jt0mkins/Pressure_Strips/pressure_strips/BOM_pressure_strips_reviewed.csv

Reference | Qty | Value | Description | Package | Manufacturer | MPN | LCSC | Voltage / Rating | Tolerance / Spec | Datasheet | Notes
U1,U2,U3,U4,U5,U6,U8,U9 | 8 | ILPS28QSW | Absolute digital barometric pressure sensor, dual FS (1260/4060 hPa), I2C / MIPI I3C, Qvar | HCLGA-7L 2.8x2.8x1.95mm | STMicroelectronics | ILPS28QSW (reel: ILPS28QSWTR) | C5267414 | 1.7-3.6 V (abs max ~4.8 V) | Pressure abs. accuracy +/-0.5 hPa | https://www.st.com/resource/en/datasheet/ilps28qsw.pdf | Fixed I2C address 0x5C (no SA0 pin) - reason the mux is needed. U8 is in the schematic but NOT placed on the PCB. AH1/AH2->GND OK when Qvar unused (AN5778); also write reg 0x5F=0x00 in FW. PAD2LID->GND OK.
U7 | 1 | TCA9548APWR | 8-channel bidirectional I2C/SMBus switch with reset | TSSOP-24 | Texas Instruments | TCA9548APWR | C130026 | 1.65-5.5 V | - | https://www.ti.com/lit/ds/symlink/tca9548a.pdf | A0/A1/A2 = GND -> address 0x70 (same as MCU-board mux; OK behind the upstream mux). RESET (pin 3) floating - add 10k to 3V3.
C1,C4,C6,C8,C10,C12,C14,C16,C18 | 9 | 100 nF | MLCC, VDD decoupling (one per sensor + one at mux) | 0402 | Yageo / Samsung | CC0402KRX7R7BB104 | verify (e.g. C15850) | 16 V (>=6.3 V) | X7R | - | C14 is missing from production/bom.csv (stale). Place one 100 nF at each ILPS28QSW VDD and at U7 VCC.
C2,C3,C5,C7,C9,C11,C13,C15,C17 | 9 | 4.7 uF | MLCC, bulk decoupling (one per sensor + one at mux) | 0402 | Samsung | CL05A475MP5NRNC | C23733 | 10 V | X5R | - | C13 is missing from production/bom.csv (stale). 4.7 uF in 0402 derates heavily with DC bias - effective C may be ~1-2 uF; acceptable for decoupling. Consider 0603 if space allows.
R1,R2,R3,R4,R5,R6,R7,R8,R9,R10,R11,R12,R13,R14,R15,R16 | 16 | 0 R (TBD) | Resistor, per-sensor I2C SDA/SCL series (mux channel -> sensor) | 0402 | UNI-ROYAL | 0402WGF0000TCE | C17168 | - | - | - | Value was 'R' (undefined). R15/R16 (Sensor 7) are missing from production/bom.csv. 0R default; 22-100R only if used for edge-rate control. NOT a substitute for pull-ups.
R17 | 1 | 0 R (was 2.2 k) | Resistor, I2C main-bus link (J1 SCL -> U7 SCL) | 0402 | UNI-ROYAL | 0402WGF0000TCE | C17168 | - | - | - | WAS 2.2k in series in the bus - wrong. Make 0R or DNP. If a per-strip SCL pull-up is wanted, add a separate R to 3V3.
R18 | 1 | 0 R (was 2.2 k) | Resistor, I2C main-bus link (J1 SDA -> U7 SDA) | 0402 | UNI-ROYAL | 0402WGF0000TCE | C17168 | - | - | - | WAS 2.2k in series in the bus - wrong. Make 0R or DNP.
J1 | 1 | 1x5 conn | Board connector to MCU board (3V3, GND, SDA, SCL, NRST) | Currently PinHeader_1x05_P2.00mm_Vertical_SMD | - | pick to mate MCU J4-J7 | - | - | - | - | MISMATCH: schematic uses a 2.00 mm pin header; production/bom.csv says JST EH 2.50 mm; MCU board uses Wuerth WR-WTB 1.50 mm. Choose ONE mating pair for both boards.
