jt0mkins/Pressure_Strips/pressure_mcu/pressure_mcu.kicad_pcb

## KiCad design pressure_mcu/pressure_mcu.kicad_pcb (2026-09-05)

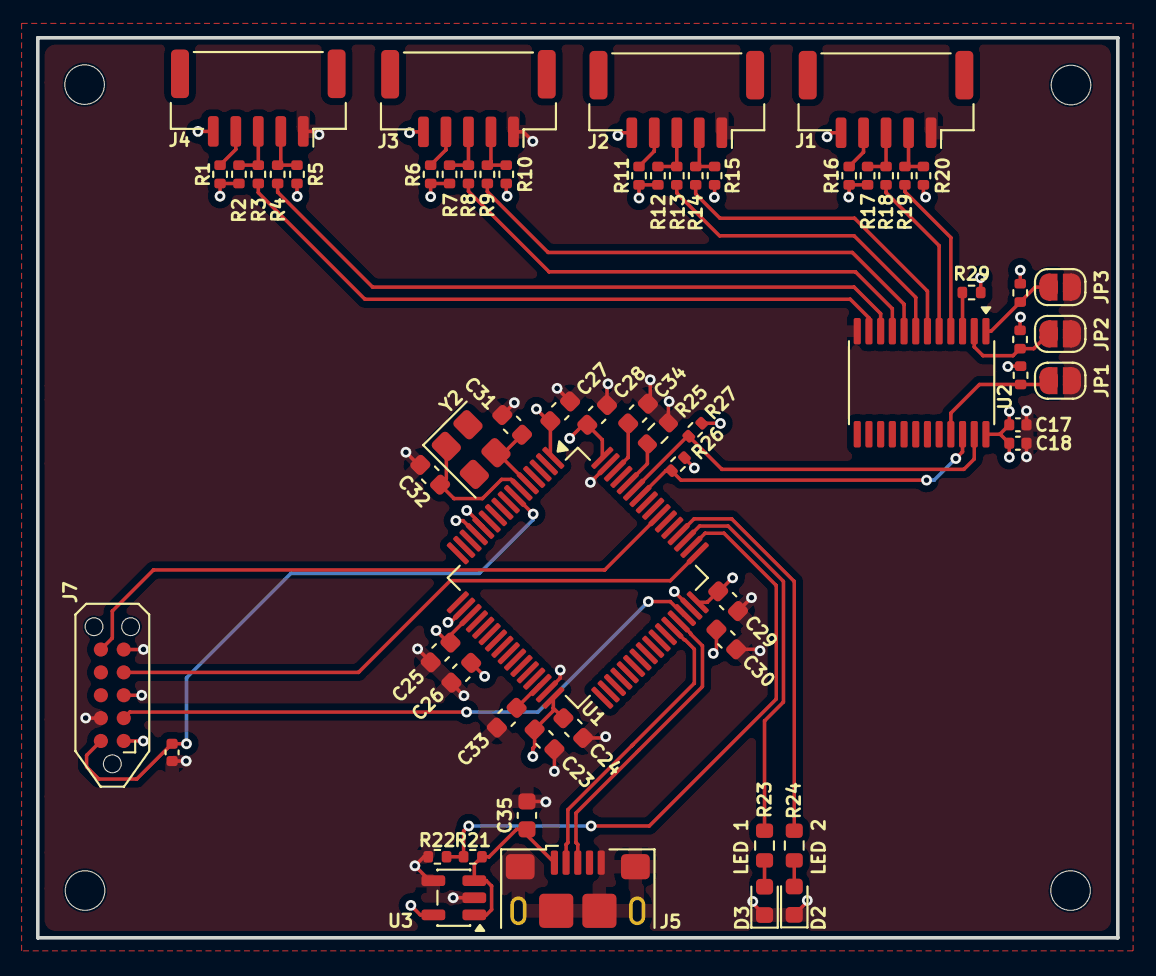
[picture p1: board pressure_mcu.kicad_pcb from above]

Board: 4 copper layers, 60.0 x 50.0 mm, 66 parts (0 on the bottom side), 45 nets.

Parts:
C17: 4.7uF; C_0402_1005Metric
C18, C36: 100nF; C_0402_1005Metric
C23, C25, C27, C29: 100nF; C_0603_1608Metric
C24, C26, C28, C30: 4.7uF; C_0603_1608Metric
C31, C32: 33pF; C_0603_1608Metric
C33, C34: 2.2uF; C_0603_1608Metric
C35: 10uF; C_0603_1608Metric
D2: LED_R; LED_0603_1608Metric
D3: LED_G; LED_0603_1608Metric
H1, H2, H3, H4: MountingHole; MountingHole_2.2mm_M2
J1: 1; JST_GH_SM05B-GHS-TB_1x05-1MP_P1.25mm_Horizontal
J2: 2; JST_GH_SM05B-GHS-TB_1x05-1MP_P1.25mm_Horizontal
J3: 3; JST_GH_SM05B-GHS-TB_1x05-1MP_P1.25mm_Horizontal
J4: 4; JST_GH_SM05B-GHS-TB_1x05-1MP_P1.25mm_Horizontal
J5: USB_B_Micro; USB_Micro-B_Amphenol_10118193-0001LF_Horizontal
J7: SWD JST PH; Tag-Connect_TC2050-IDC-NL_2x05_P1.27mm_Vertical_with_bottom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
JP1, JP2, JP3: SolderJumper_2_Open; SolderJumper-2_P1.3mm_Open_RoundedPad1.0x1.5mm
R1, R6, R11, R16, R21, R29, R30, R31, R32: 10k; R_0402_1005Metric
R2, R5, R7, R10, R12, R15, R17, R20, R26, R27: 2.2k; R_0402_1005Metric
R3, R4, R8, R9, R13, R14, R18, R19: 0; R_0402_1005Metric
R22: 15k; R_0402_1005Metric
R23, R24: 220R; R_0603_1608Metric
R25: 10k; R_0603_1608Metric
U1: STM32H562RGT6; LQFP-64_10x10mm_P0.5mm
U2: TCA9548APWR; TSSOP-24_4.4x7.8mm_P0.65mm
U3: AP2112K-3.3; SOT-23-5
Y2: 12MHz; Crystal_SMD_Abracon_ABM8G-4Pin_3.2x2.5mm

Connections:
+3V3: C17.1, C18.1, C23.1, C24.1, C25.1, C26.1, C27.1, C28.1, C29.1, C30.1, J1.5, J2.5, J3.5, J4.5, J7.1, R1.1, R2.1, R5.1, R6.1, R7.1, R10.1, R11.1, R12.1, R15.1, R16.1, R17.1, R20.1, R26.1, R27.1, R29.1, R30.1, R31.1, R32.1, U1.1 (VBAT), U1.13 (VDDA), U1.19 (VDD), U1.32 (VDD), U1.48 (VDD), U1.64 (VDD), U2.24 (VCC), U3.5 (VOUT)
/A0: JP3.2 (B), R30.2, U2.1 (A0)
/A1: JP2.2 (B), R31.2, U2.2 (A1)
/A2: JP1.2 (B), R32.2, U2.21 (A2)
/LED1: R23.1, U1.51 (PC10)
/LED2: R24.1, U1.52 (PC11)
/MUX1_NRST: J2.4, R11.2
/MUX1_SCL: J2.3, R12.2, R13.2
/MUX1_SDA: J2.2, R14.2, R15.2
/MUX2_NRST: J1.4, R16.2
/MUX2_SCL: J1.3, R17.2, R18.2
/MUX2_SDA: J1.2, R19.2, R20.2
/MUX3_NRST: J3.4, R6.2
/MUX3_SCL: J3.3, R7.2, R8.2
/MUX3_SDA: J3.2, R9.2, R10.2
/MUX4_NRST: J4.4, R1.2
/MUX4_SCL: J4.3, R2.2, R3.2
/MUX4_SDA: J4.2, R4.2, R5.2
/MUX_NRST: R29.2, U2.3 (~RESET)
/MUX_SCL: R26.2, U1.58 (PB6), U2.22 (SCL)
/MUX_SDA: R27.2, U1.59 (PB7), U2.23 (SDA)
/SWCLK: J7.4, U1.49 (PA14(JTCK)
/SWDIO: J7.2, U1.46 (PA13(JTMS)
/SWO: J7.6, U1.55 (PB3(JTDO)
/USB_D+: J5.3 (D+), U1.45 (PA12)
/USB_D-: J5.2 (D-), U1.44 (PA11)
/V_BUS: C35.1, J5.1 (VBUS), R21.1, U3.1 (VIN), U3.3 (EN)
/V_SENSE: R21.2, R22.1, U1.50 (PA15(JTDI))
/nRESET: C36.2, J7.10, U1.7 (NRST)
GND: C17.2, C18.2, C23.2, C24.2, C25.2, C26.2, C27.2, C28.2, C29.2, C30.2, C31.1, C32.2, C33.2, C34.2, C35.2, C36.1, D2.1 (K), D3.1 (K), J1.1, J2.1, J3.1, J4.1, J5.5 (GND), J5.SH (Shield), J7.3, J7.5, J7.9, JP1.1 (A), JP2.1 (A), JP3.1 (A), R22.2, R25.2, U1.12 (VSSA), U1.18 (VSS), U1.31 (VSS), U1.47 (VSS), U1.63 (VSS), U2.12 (GND), U3.2 (GND), U3.4 (GND)
unnamed: C33.1, U1.30 (VCAP)
unnamed: C34.1, U1.62 (VCAP)
unnamed: D2.2 (A), R24.2
unnamed: D3.2 (A), R23.2
unnamed: R25.1, U1.60 (BOOT0)
unnamed: C31.2, U1.5 (PH0), Y2.3 (2)
unnamed: C32.1, U1.6 (PH1), Y2.1
unnamed: R18.1, U2.5 (SC0)
unnamed: R13.1, U2.7 (SC1)
unnamed: R8.1, U2.9 (SC2)
unnamed: R3.1, U2.11 (SC3)
unnamed: R19.1, U2.4 (SD0)
unnamed: R14.1, U2.6 (SD1)
unnamed: R9.1, U2.8 (SD2)
unnamed: R4.1, U2.10 (SD3)
