jt0mkins/Pressure_Strips/pressure_strips/pressure_strips.kicad_pcb

## KiCad design pressure_strips/pressure_strips.kicad_pcb (2026-07-28)

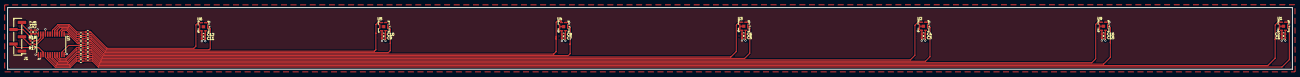
[picture p2: board pressure_strips.kicad_pcb from above]

Board: 4 copper layers, 357.3 x 17.2 mm, 41 parts (0 on the bottom side), 35 nets.

Parts:
C1, C4, C6, C8, C10, C12, C16, C18: 100nF; C_0402_1005Metric
C2, C3, C5, C7, C9, C11, C15, C17: 4u7F; C_0402_1005Metric
J1: Conn_01x05; PinHeader_1x05_P2.00mm_Vertical_SMD_Pin1Left
R1, R2, R3, R4, R5, R6, R7, R8, R9, R10, R11, R12, R13, R14: R; R_0402_1005Metric
R17, R18: 2.2k; R_0402_1005Metric
U1, U2, U3, U4, U5, U6, U9: ILPS28QSW; ST_CCLGA-7L_2.8x2.8mm_P1.15mm_H1.95mm
U7: TCA9548APWR; TSSOP-24_4.4x7.8mm_P0.65mm

Connections:
+3V3: C1.1, C2.1, C3.1, C4.1, C5.1, C6.1, C7.1, C8.1, C9.1, C10.1, C11.1, C12.1, C15.1, C16.1, C17.1, C18.1, J1.5, U1.6 (VDD), U2.6 (VDD), U3.6 (VDD), U4.6 (VDD), U5.6 (VDD), U6.6 (VDD), U7.24 (VCC), U9.6 (VDD)
/MUX_NRST: J1.2, U7.3 (~RESET)
/MUX_SCL: J1.3, R17.2
/MUX_SDA: J1.4, R18.2
/Sensor0_SCL: R1.2, U1.3 (SCL)
/Sensor0_SDA: R2.2, U1.1 (SDA)
/Sensor1_SCL: R3.2, U9.3 (SCL)
/Sensor1_SDA: R4.2, U9.1 (SDA)
/Sensor2_SCL: R5.2, U2.3 (SCL)
/Sensor2_SDA: R6.2, U2.1 (SDA)
/Sensor3_SCL: R7.2, U3.3 (SCL)
/Sensor3_SDA: R8.2, U3.1 (SDA)
/Sensor4_SCL: R9.2, U4.3 (SCL)
/Sensor4_SDA: R10.2, U4.1 (SDA)
/Sensor5_SCL: R11.2, U5.3 (SCL)
/Sensor5_SDA: R12.2, U5.1 (SDA)
/Sensor6_SCL: R13.2, U6.3 (SCL)
/Sensor6_SDA: R14.2, U6.1 (SDA)
GND: C1.2, C2.2, C3.2, C4.2, C5.2, C6.2, C7.2, C8.2, C9.2, C10.2, C11.2, C12.2, C15.2, C16.2, C17.2, C18.2, J1.1, U1.2 (AH1/QVAR1), U1.4 (AH2/QVAR2), U1.5 (GND), U1.7 (PAD2LID), U2.2 (AH1/QVAR1), U2.4 (AH2/QVAR2), U2.5 (GND), U2.7 (PAD2LID), U3.2 (AH1/QVAR1), U3.4 (AH2/QVAR2), U3.5 (GND), U3.7 (PAD2LID), U4.2 (AH1/QVAR1), U4.4 (AH2/QVAR2), U4.5 (GND), U4.7 (PAD2LID), U5.2 (AH1/QVAR1), U5.4 (AH2/QVAR2), U5.5 (GND), U5.7 (PAD2LID), U6.2 (AH1/QVAR1), U6.4 (AH2/QVAR2), U6.5 (GND), U6.7 (PAD2LID), U7.1 (A0), U7.2 (A1), U7.12 (GND), U7.21 (A2), U9.2 (AH1/QVAR1), U9.4 (AH2/QVAR2), U9.5 (GND), U9.7 (PAD2LID)
unnamed: R1.1, U7.5 (SC0)
unnamed: R3.1, U7.7 (SC1)
unnamed: R5.1, U7.9 (SC2)
unnamed: R7.1, U7.11 (SC3)
unnamed: R9.1, U7.14 (SC4)
unnamed: R11.1, U7.16 (SC5)
unnamed: R13.1, U7.18 (SC6)
unnamed: R17.1, U7.22 (SCL)
unnamed: R2.1, U7.4 (SD0)
unnamed: R4.1, U7.6 (SD1)
unnamed: R6.1, U7.8 (SD2)
unnamed: R8.1, U7.10 (SD3)
unnamed: R10.1, U7.13 (SD4)
unnamed: R12.1, U7.15 (SD5)
unnamed: R14.1, U7.17 (SD6)
unnamed: R18.1, U7.23 (SDA)
