jt0mkins/Pressure_Strips/(commit log)

2026-07-07 initila commit
    [bom.csv, designators.csv, positions.csv, pressure_strips.kicad_pcb, pressure_strips.kicad_sch]
2026-07-28 strips done, finishing off mcu
    [pressure_mcu.kicad_pcb, pressure_mcu.kicad_sch, pressure_strips.kicad_pcb, pressure_strips.kicad_sch]
2026-07-28 pressure mcu schematic almost done
    [pressure_mcu.kicad_pcb, pressure_mcu.kicad_sch]
2026-09-05 ready for review
    [BOM_pressure_mcu_reviewed.csv, BOM_pressure_strips_reviewed.csv, bom.csv, designators.csv, positions.csv, pressure_mcu.kicad_pcb]
